ehajo/Optilia-Fernbedienung/README.md

# Optilia-Fernbedienung
 Optilia Reverse Engineeren
