ehajo/Optilia-Fernbedienung/hardwareanforderungen.txt

Hardwareanforderungen für Visca-Platine:

Raspberry Pi Pico W

X- Potentiometer (für zB Zoomstufe)
X- Inkrementalgeber mit Tastefunktion (Für zB Menü, ...)
X- OLED-Display 0,96"
X- Tasten (Freeze, Chatkontrolle, Autofokus, Ein/Aus) mit 2 LEDs integriert (rot grün)
X- MAX3232 für UART 

Durchmesser Poti/Inkrementalgeberknopf: 25mm

inkrementalgeber höhe 13mm. unten 3mm hoch: 7mm durchmesser ausnehmen.
knopf gesamthöhe 15mm
