ehajo/Optilia-Fernbedienung/CAD/drehknopf-zoom.stp

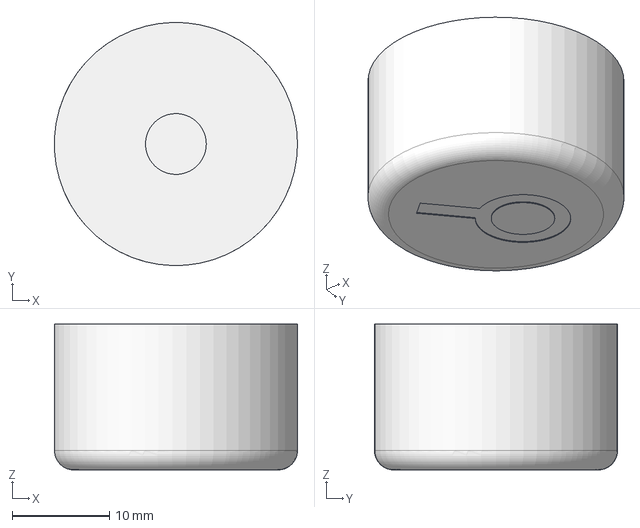
[picture p1: CAD file, 2025-02-03]
CAD/drehknopf-zoom.stp
25.0 x 25.0 x 15.0 mm
