ehajo/Optilia-Fernbedienung/CAD/Oberteil.stp

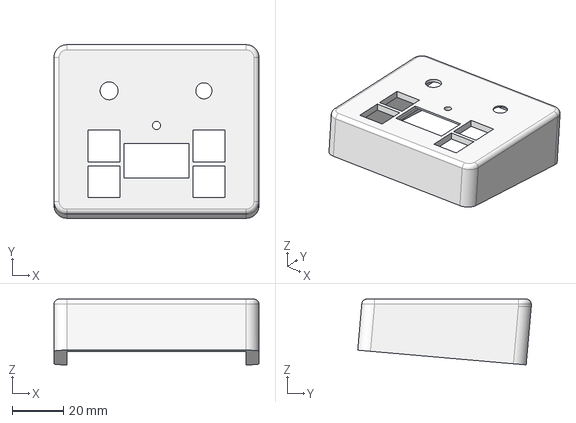
[picture p2: CAD file, 2025-01-28]
CAD/Oberteil.stp
80.0 x 67.7 x 25.7 mm
