ehajo/Optilia-Fernbedienung/CAD/unterteil.stp

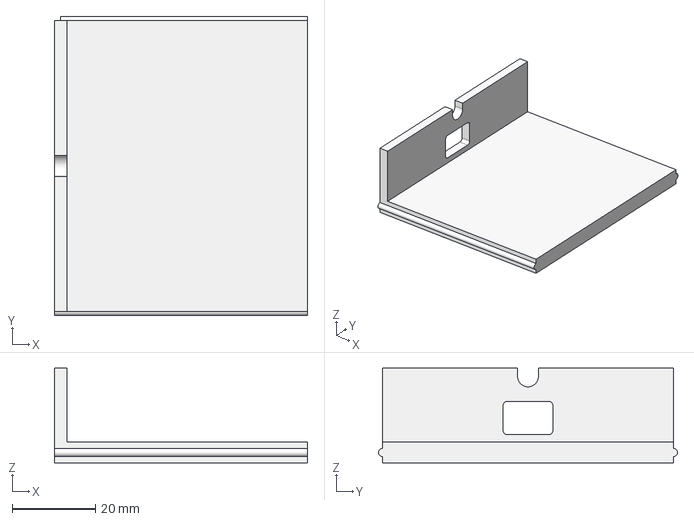
[picture p3: CAD file, 2025-01-28]
CAD/unterteil.stp
61.0 x 72.0 x 22.8 mm
