ehajo/Optilia-Fernbedienung/(list of files, cad)

Other CAD files:
CAD/drehknopf-ink.stp
CAD/drehknopf-ink.3mf
