ehajo/Optilia-Fernbedienung/(list of files, drawings)

Other design files:
Platine/visca-controller.pcb
