ehajo/Optilia-Fernbedienung/(commit log)

2024-12-25 Stream 23.12.
    Analyse der Befehle. Alle soweit getestet und korrekt interpretiert
    [UART-Befehle.ods]
2025-01-09 aktualisierung
    Weitere Befehle analysiert und rausgefunden, dass es sich um ein VISCA protokoll handelt
    [UART-Befehle.ods]
2025-01-11 initial commit
    erster coderversuch mit chatgpt und circuitpyton
2025-01-14 initial commi
    [Backup-visca-controller-1.sch, Backup-visca-controller-2.sch, Backup-visca-controller-3.sch, Securitycopy-visca-controller-1.sch, Securitycopy-visca-controller-2.sch, Securitycopy-visca-controller-3.sch, visca-controller.sch]
2025-01-20 streamwork
    PCB finished, step generated
    [visca-controller(Bottom).gbr, visca-controller(Drill Drawing).gbr, visca-controller(Paste Mask Bottom).gbr, visca-controller(Paste Mask Top).gbr, visca-controller(Silkscreen Bottom).gbr, visca-controller(Silkscreen Top).gbr, visca-controller(Solder Mask Bottom).gbr, visca-controller(Solder Mask Top).gbr]
2025-01-28 CAD Files initial commit
    [Oberteil.stp, unterteil.stp]
2025-01-28 streamwork
    code für die neue platine angepasst.
    offstream-work: display angesteuert und AF/MF umschaltung
2025-02-02 initial commit
    poti- und inkrementalgeber knopf erstellt. ink-knopf noch etwas nachoptimiert nach dem stream
    [drehknopf-ink.3mf, drehknopf-ink.stp, drehknopf-zoom.stp]
2025-02-02 current stat
    aktueller stand nach stream mit freeze funktion
2025-02-03 updated
    Optimierter Durchmesser etc
    [drehknopf-zoom.stp]
2025-02-05 minor changes
    [visca-controller.sch]
2025-02-05 es geht und läuft und überhaupt
    version vom streamende. mit allen möglichen funktionen. läuft aktuell tadellos. mit !zoom über twitch-chat bei hervorgehobenen nachrichten, mit kamera overlaytext etc.... einfach hammer!
    [code.py]
2025-02-06 initial commit
    danke chatgpt für die tolle doku!
2025-02-06 Minor changes
    Ein paar Optimierungen, mal nen (c) text am anfang, smiley für connection status, optilia emoji für twitch nachrichten und some other minor changes
    [code.py]
2025-02-06 Verschoben
    Und jetzt das Ganze noch in passende Ordner, die Software hat eigentlich in reverse engi nix zu suchen und kriegt daher einen eigenen Ordner!
2025-02-18 massive changes!
    - wenn kein gültiger zoomwert etc wird kein kamerakind angezeigt!
    - zoom von chat auf 20s dauer
    - balkenanzeige mit verbleibender zeit von chat-zoom
    - wifi-handling überarbeitet, wenn kein wifi
    - optimierungen bzw speed
    - helligkeit nun per inkrementalgeber einstellbar
    - statusanzeige für helligkeitswert auf display
    - tausend dinge, dich ich schon wieder vergessen hab
2025-02-20 Unglaubliches Update
    Grok3 beta ist echt der Wahnsinn. Ich habe den alten Code reinkopiert und er hat ihn mir enorm (wirklich enorm) verbessert:
    - modularisiert
    - effizienter
    - alles geht viel viel schneller, tastenreaktion besser etc
    - vieles mehr!
2025-02-21 small changes
    Kleine optimierungen, damit der startup besser funktioniert
2025-02-22 Textoverlay und Kleinigkeiten
    - Startemeldung im Display, wenn die Kamera eingeschaltet wird
    - text-overlay komplett überarbeitet
    - freeze wird jetzt wieder korrekt angezeigt
    - kamerakind wird in zeile 1 und 2 angezeigt
    - links unten befindet sich im twitch-modus jetzt die aktuelle zoomstufe
    [main.py, visca_commands.py]
